den4ik86/Smart_Ring/Разработка автоматизированной системы управления школьными звонками .pptx

## Разработка автоматизированной системы управления школьными звонками «Умный звонок»

Индивидуальный проект
Автор: Чувашов Денис Владимирович,11 класс
Руководитель: Румянцев Владимир Алексанрович
Год: 2026

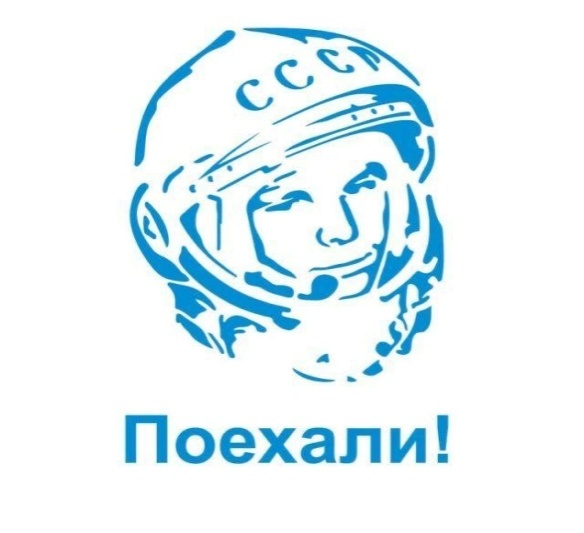
[picture p8: figure]

## Почему это важно?

❌ В большинстве школ звонки включают вручную
❌ Старые реле времени не привязаны к дням недели
❌ Нет голосового оповещения о начале/конце урока
❌ Нет музыки на переменах
❌ Готовые решения дороги (20 000 – 30 000 ₽)

## Цель и задачи проекта

Цель: Создать доступную автоматизированную систему управления школьными звонками
Задачи:
1. Изучить существующие решения
2. Выбрать компоненты
3. Разработать схему подключения
4. Написать программу для ESP32
5. Создать веб-интерфейс
6. Протестировать систему

## Аппаратная платформа

Компонент | Модель | Назначение
Микроконтроллер | ESP32 | Управление, Wi-Fi
Часы реального времени | DS1307 | Точное время
ЦАП | MAX98357 | Звук (I2S)
SD-карта | 8 ГБ | Хранение MP3
Реле | SRD-12VDC | Управление звонком

## Принципиальная схема прибора


## Как это работает


## Подключение компонентов к ESP32

Пин ESP32 | Компонент | Назначение
15 | Реле | Звонок
33 | Кнопка | Пожар
32 | Кнопка | Террор
2 | Светодиод | Индикация пожара
4 | Светодиод | Индикация террора
27/26/25 | I2S | Аудио
18/19/23/5 | SPI | SD-карта

## Что умеет «Умный звонок»?

1. 🔔 Автоматические звонки по расписанию
2. 📅 7 профили (по дням недели)
3. 🎤 Голосовое оповещение (начало/конец урока)
4. 🎵 Музыка на переменах (2 режима)
5. 🚨 Пожарная и террористическая тревога
6. 🌐 Веб-управление с телефона
7. 📁 Загрузка MP3 через браузер

## Управление через браузер

1. Расписание звонков
2. Подсветка идущего урока
3. Вкл/Выкл музыки
4. Выбор режима воспроизведения

## Веб интерфейс


## Slide 11


## Slide 12


## Slide 13

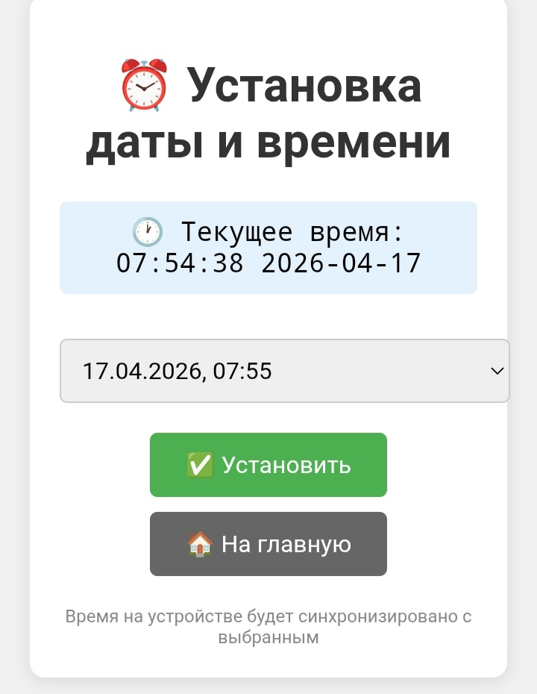
[picture p9: figure]

## Slide 14

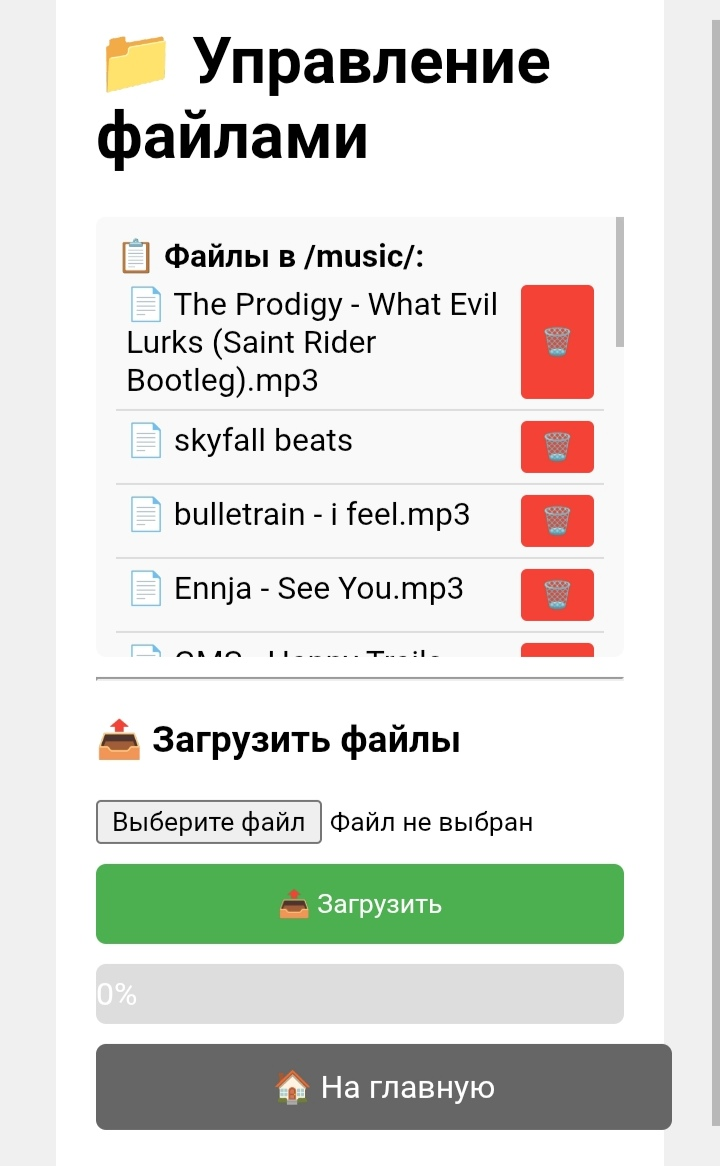
[picture p10: figure]

## Все тесты пройдены успешно

1. ✅ Звонки по расписанию
2. ✅ Голосовое оповещение
3. ✅ Музыка на переменах
4. ✅ Переключение профилей
5. ✅ Пожарная тревога
6. ✅ Террористическая тревога
7. ✅ Веб-управление
8. ✅ Загрузка MP3

## Почему «Умный звонок»лучше?

1. 💰 Низкая стоимость — 10000₽ (доступно любой школе)
2. 🎤 Голосовое оповещение — начало и конец урока озвучивается
3. 🎵 Музыка на переменах — 2 режима воспроизведения
4. 📅 Гибкое расписание — 7 профилей по дням недели
5. 🌐 Простая настройка — веб-интерфейс для управления с телефона
6. 🚨 Экстренные тревоги — пожар и террор

## Результаты работы

1. ✅ Цель достигнута
2. ✅ Все задачи выполнены
3. ✅ Устройство работает стабильно
4. ✅ Готово к внедрению в школу

## Подключение к устройству

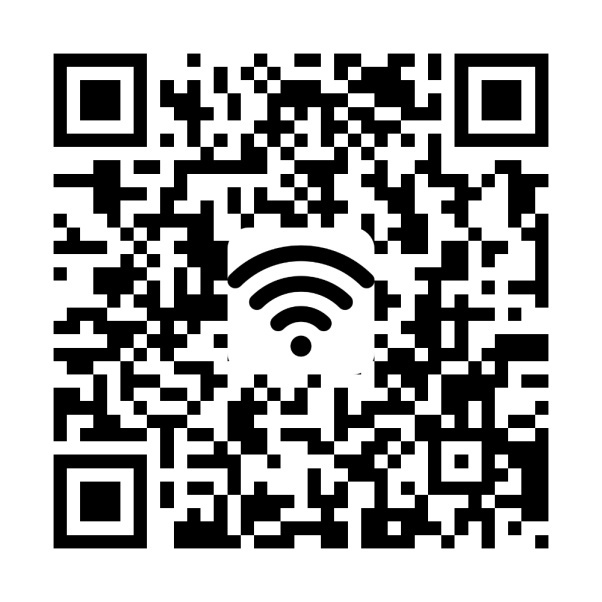
[picture p11: figure]

Больше проектов на моём GitHub

Спасибо за внимание!
